nalex09/nalex09/hardware/docs/parts-list.pdf

Part | Link | Price per Package (12.07.23) | Package Size | Pieces needed for one assembly | Price for one assembly (12.07.23)
WiFi Kit ESP32 WiFi Wireless mit 0,96 Zoll OLED Display (causion: buy the Wifi version, no the one with LoRa!) | https://www.amazon.de/gp/product/B078MCR8FY/ref=ppx_yo_dt_b_asin_title_o04_s01?ie=UTF8&psc=1 | 22,99 € | 1 | 1 | 22,99 €
WayinTop 5 Stück Rotary Encoder Modul KY-040 | https://www.amazon.de/gp/product/B07T3672VK/ref=ppx_yo_dt_b_asin_title_o04_s00?ie=UTF8&psc=1 | 10,99 € | 5 | 1 | 2,20 €
Miuzei 270° Digital RC Servo Motor 20KG | https://www.amazon.de/gp/product/B07Q65JY1K/ref=ppx_yo_dt_b_asin_title_o04_s00?ie=UTF8&psc=1 | 15,89 € | 1 | 1 | 15,89 €
diymore Metall Servoarm 25T Disc | https://www.amazon.de/diymore-Metall-Servoarm-MG996R-Roboter/dp/B07G5BTMJB/ref=psdc_12950661_t1_B07F71J1Q2 | 6,99 € | 6 | 1 | 1,17 €
Load Cell 1kg with HX711 | https://www.amazon.de/gp/product/B073GXMDNY/ref=ppx_yo_dt_b_asin_title_o05_s00?ie=UTF8&psc=1 | 9,99 € | 1 | 1 | 9,99 €
RUNCCI-YUN 10pcs 12mm Pushbutton Waterproof | https://www.amazon.de/gp/product/B0B3QYVMVF/ref=ppx_yo_dt_b_asin_title_o05_s01?ie=UTF8&psc=1 | 9,98 € | 10 | 2 | 2,00 €
6 Pieces Rocker switch | https://www.amazon.de/gp/product/B087M7XVHR/ref=ppx_yo_dt_b_asin_title_o05_s01?ie=UTF8&psc=1 | 7,99 € | 6 | 1 | 1,33 €
Hollow plug round plug for power supply 5,5 x2,1 | https://www.ebay.de/itm/165688559733?var=465201624528https://www.ebay.de/itm/162724900298 | 1,86 € | 10 | 1 | 0,19 €
Power supply: 5V / 3000mA (5,5*2,5mm / 2,1mm) | https://www.ebay.de/itm/124101179051?var=425713465497 | 9,19 € | 1 | 1 | 9,19 €
Screw M6 x 50mm | https://www.ebay.de/itm/115139841197?var=415207287757 | 4,45 € | 10 | 1 | 0,45 €
Screw M5 x 20mm Countersunk head | https://www.ebay.de/itm/113997747668?var=414281832157 | 3,92 € | 10 | 2 | 0,78 €
Screw M4 x 20mm Countersunk head | https://www.ebay.de/itm/113997747668?var=414281832072 | 3,67 € | 10 | 2 | 0,73 €
Foliv 570 PCS Edelstahl M3 Screws and nuts assortment 1x M3x30 + Nut + Washers (for the Servo Arm) 2x M3x20 + Nut + Washers (for the Servo Mount) 5x M3x15 + Washers (for mounting Gear to Servo) | https://www.amazon.de/gp/product/B0939L6G9W/ref=ppx_yo_dt_b_asin_title_o03_s02?ie=UTF8&psc=1 | 12,74 € | 570 | 20 | 0,45 €
Imgut® Plastik-Quetschhahn | https://www.holtermann-shop.de/Honigernte/abfuell-eimer-haehne/Imgut---Plastik-Quetschhahn.htmlhttps://www.holtermann-shop.de/honigernte/honig-abfuellen-1562/abfuell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 | 9,90 € | 1 | 1 | 9,90 €
Parts Price for assembly of one unit | 77,25 €
