nalex09/nalex09/hardware/step/housing-upper-part.step

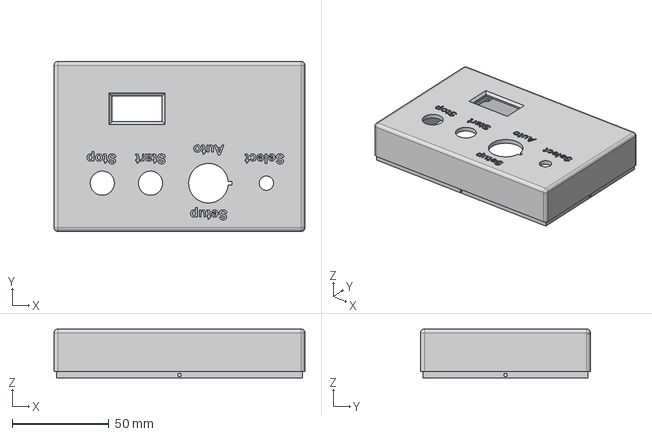
[picture p7: CAD file, 2026-11-11]
hardware/step/housing-upper-part.step
130.0 x 88.0 x 25.4 mm
