nalex09/nalex09/hardware/step/scale-topping-plate.step

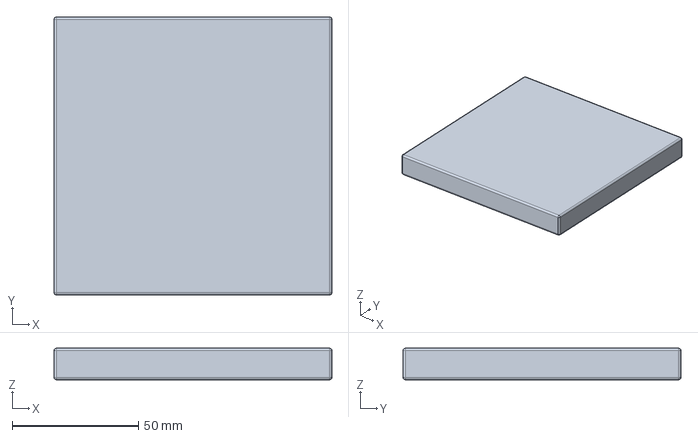
[picture p8: CAD file, 2026-11-11]
hardware/step/scale-topping-plate.step
110.0 x 110.0 x 12.5 mm
