nalex09/nalex09/hardware/step/housing-ground-part.step

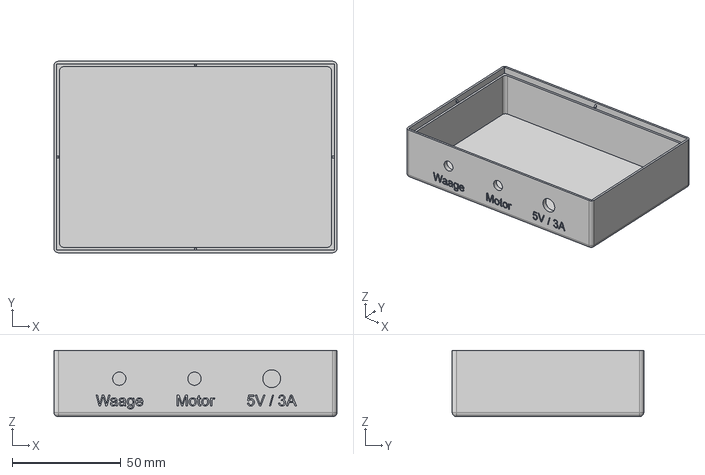
[picture p9: CAD file, 2026-11-11]
hardware/step/housing-ground-part.step
130.0 x 88.0 x 30.5 mm
