nalex09/nalex09/hardware/step/gear-on-servo.step

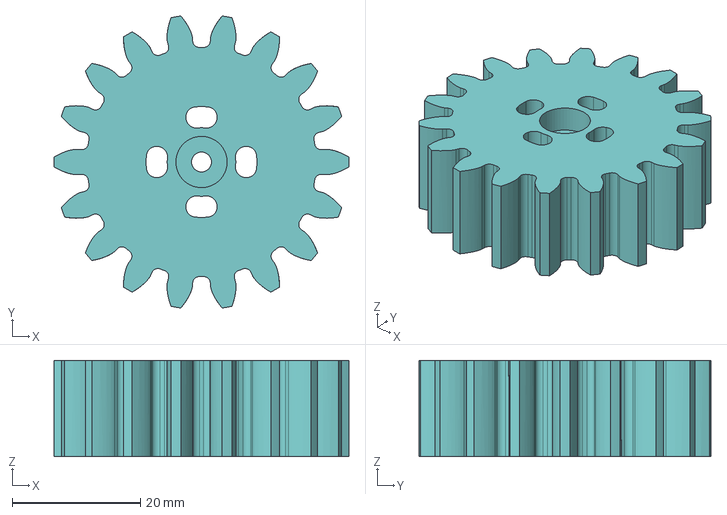
[picture p10: CAD file, 2026-11-11]
hardware/step/gear-on-servo.step
46.0 x 45.5 x 15.0 mm
