nalex09/nalex09/hardware/step/scale-ground-plate.step

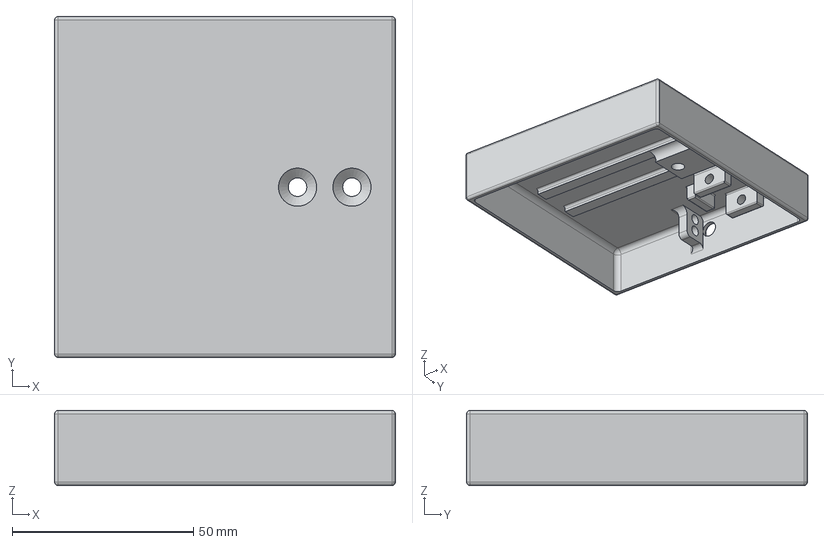
[picture p11: CAD file, 2026-11-11]
hardware/step/scale-ground-plate.step
94.0 x 94.0 x 20.7 mm
