nalex09/nalex09/hardware/step/scale-top-plate.step

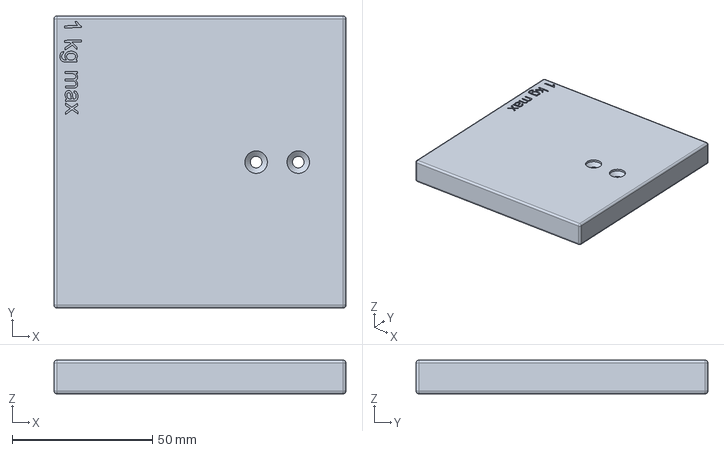
[picture p12: CAD file, 2026-11-11]
hardware/step/scale-top-plate.step
104.0 x 104.0 x 12.0 mm
