nalex09/nalex09/hardware/step/servo-mounting-plate.step

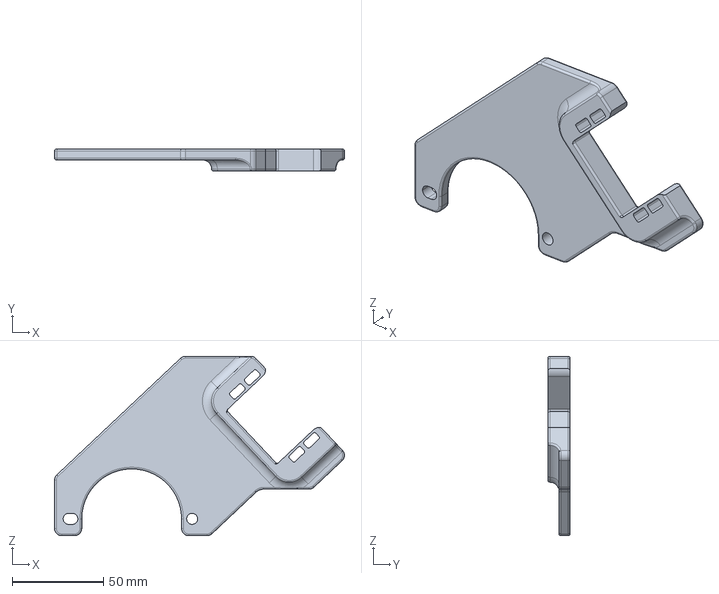
[picture p13: CAD file, 2026-11-11]
hardware/step/servo-mounting-plate.step
158.5 x 12.0 x 98.1 mm
