nalex09/nalex09/hardware/step/gear-arm.step

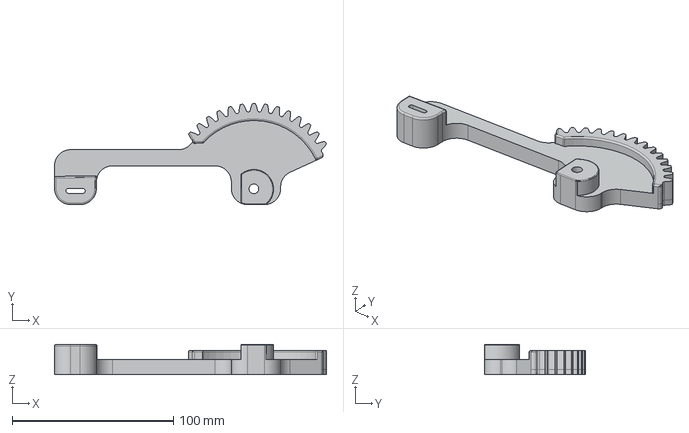
[picture p14: CAD file, 2026-11-11]
hardware/step/gear-arm.step
168.4 x 62.7 x 18.8 mm
