nalex09/nalex09/(list of files, cad)

Other CAD files:
hardware/hanimandl-rallef80.f3d
hardware/stl/gear-arm.stl
hardware/stl/gear-on-servo.stl
hardware/stl/housing-ground-part.stl
hardware/stl/housing-upper-part.stl
hardware/stl/scale-ground-plate.stl
hardware/stl/scale-top-plate.stl
hardware/stl/scale-topping-plate.stl
hardware/stl/servo-mounting-plate.stl
