nalex09/nalex09/hardware/docs/printables-524971-descriere.pdf

## Filling machine "Hanimandl"

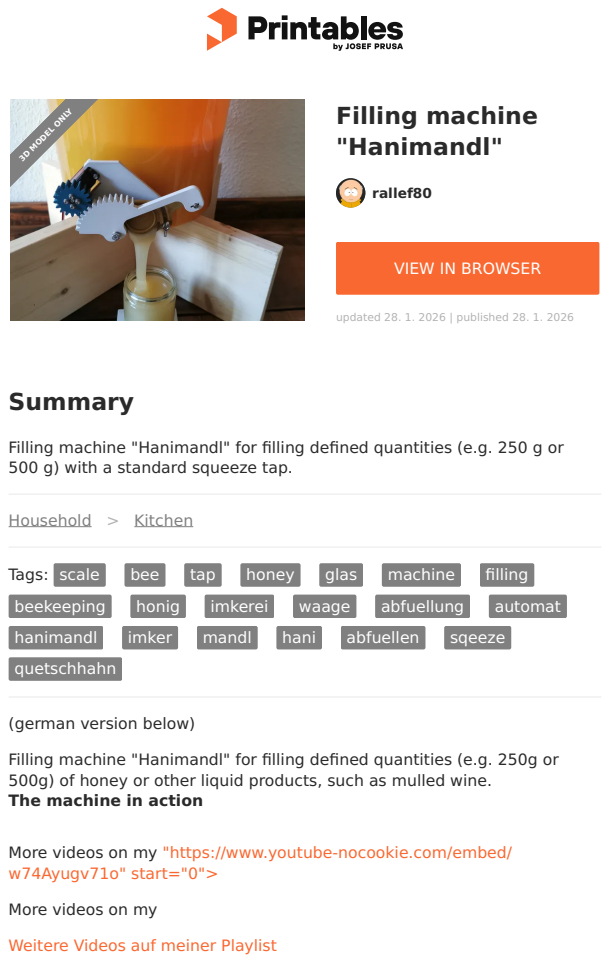
[picture p15: page 1]
Summary; Household > Kitchen; Tags:; scale; bee; tap; honey; glas; machine; filling; beekeeping; honig; imkerei; waage; abfuellung; automat; hanimandl; imker; mandl; hani; abfuellen; sqeeze; quetschhahn; rallef80; updated 28. 1. 2026 | published 28. 1. 2026; 3D MODEL ONLY

VIEW IN BROWSER (https://printables.com/model/524971-filling-machine-hanimandl)

Filling machine "Hanimandl" for filling defined quantities (e.g. 250 g or
500 g) with a standard squeeze tap.

(german version below)

Filling machine "Hanimandl" for filling defined quantities (e.g. 250g or
500g) of honey or other liquid products, such as mulled wine.
The machine in action

More videos on my "https://www.youtube-nocookie.com/embed/
w74Ayugv71o" start="0"> (https://www.youtube.com/playlist?list=PLBxxNxYgCrRPP5T8Fc4HkIMN0lKi9nC2f)

More videos on my

Weitere Videos auf meiner (https://www.youtube.com/playlist?list=PLBxxNxYgCrRPP5T8Fc4HkIMN0lKi9nC2f) Playlist (https://www.youtube.com/playlist?list=PLBxxNxYgCrRPP5T8Fc4HkIMN0lKi9nC2f)

Aufbauanleitung
Eine Bauanleitung für die elektrischen Komponenten und die benötigte Software für den Mikrocontroller sind auf Github zu finden unter: https://github.com/hiveeyes/hanimandl

An dieser Stelle einen herzlichen Dank an das Team von Hanimandl!

Mechanik am Quetschhahn
Abweichend von einigen bereits vorhandenen Konstruktionsvorschlägen arbeitet diese Version hier mit einer Bewegung des Quetschhahns über einen Zahnradantrieb. Dies bietet den Vorteil, dass in jeder Stellung des Hahnes das volle Drehmoment auf den Hahn übertragen werden kann. Der Hahn kann dadurch recht fest verschraubt sein und gut abdichten. Außerdem ist es über diese Konstruktion möglich, den Hahn auch vollständig zu öffnen, was vor allem bei besonders zähen Honigen Vorteile bietet. Die Halterung für den Servomotor ist fest mit dem Quetschhahn verbunden.

Kontrolleinheit
In der Kontrolleinheit sind alle Bedienelemente und der zugehörige Mikrocontroller mit Display eingebracht. Das Gehäuse besteht aus einem Oberteil und einem Unterteil, welche in einander gesteckt werden. Eine Schraubverbindung ist nicht nötig.
Update 11/2023: Das Oberteil des Gehäuses wurde vereinfacht. Der Controller wird jetzt nur eingelegt und mit Sekundenkleber befestigt.

Waage
Die Waage besteht aus drei Einzelteilen. In das Unterteil wird die Wägezelle und die zugehörige Elektronik (HX711) eingesetzt. Anschließend wird die Deckplatte mit der Wägezelle verschraubt. Damit kein Honig auf die Schrauben tropfen kann, kann noch eine Abdeckplatte gedruckt werden, die auf das Oberteil aufgesetzt wird.

Elektronik
Für den Aufbau der Elektronik finden sich Hinweise unter dem oben angegebenen Github-Link. Speziell für den Einsatz des aktuellen Heltec Wifi V3 Controllers, werden unter folgendem Link noch die Pinbelegungen erklärt:
https://community.hiveeyes.org/t/kann-ich-auch-das-heltec-wifi-kit-32-in-der-neuen-version-v3-verwenden/4696/24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 (https://community.hiveeyes.org/t/kann-ich-auch-das-heltec-wifi-kit-32-in-der-neuen-version-v3-verwenden/4696/24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)

Anpassungen an der Software
Damit der Mikrocontroller die richtige Drehrichtung für die Zahnradkonstruktion vornimmt, muss folgende Zeile im Quellcode vorhanden sein (in der Datei “hanimandl.ino” in Zeile 117 einfach die Kommentarzeichen “//” entfernen):

## Model files

#define QUETSCHHAHN_LINKS

Bauteilliste und Projektdatei
Im Anhang befindet sich eine Liste mit Vorschlägen für die Bauteile. Weiterhin ist die Projektdatei für Fusion 360 beigefügt, damit auch Änderungen an der Konstruktion vorgenommen werden können, falls bspw. andere Bedienelemente in das Gehäuse eingepasst werden sollen.

Gedruckt wurden alle Teile in PLA.

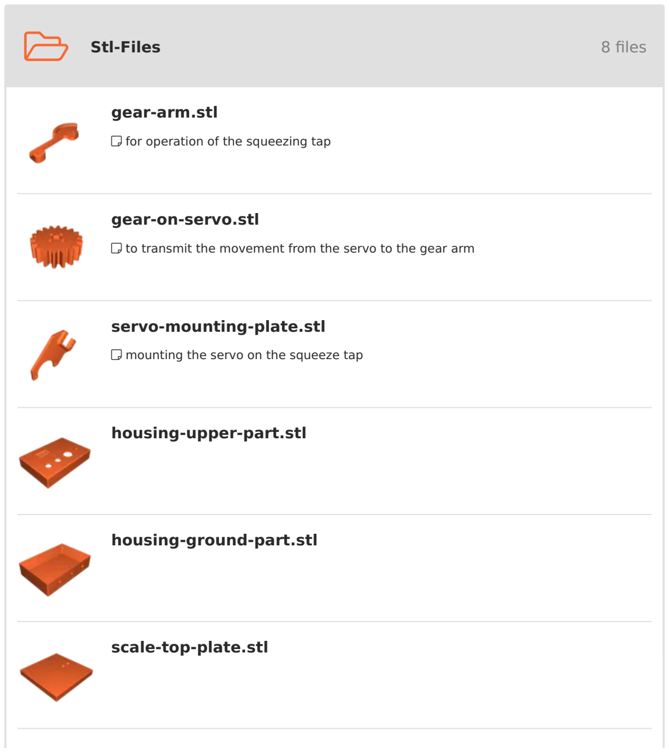
[picture p16: figure]
Stl-Files; 8 files; for operation of the squeezing tap; mounting the servo on the squeeze tap; gear-arm.stl; gear-on-servo.stl; servo-mounting-plate.stl; housing-upper-part.stl; housing-ground-part.stl; scale-top-plate.stl

- to transmit the movement from the servo to the gear arm

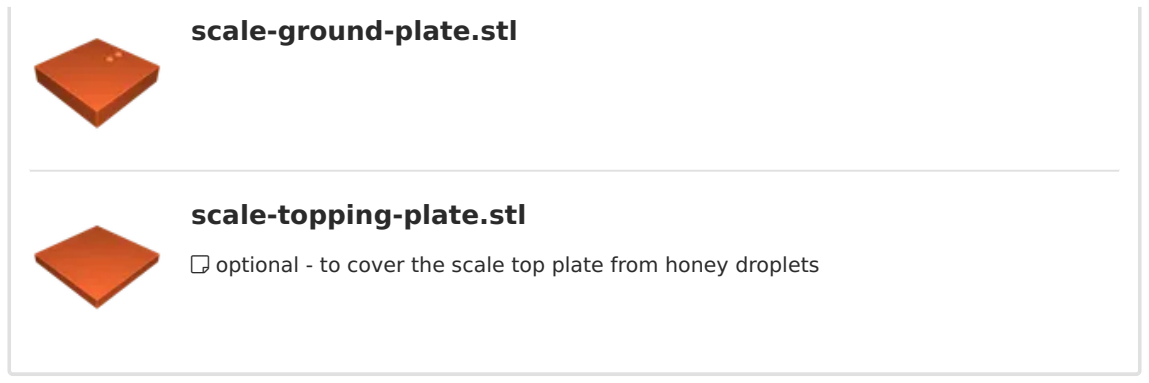
[picture p17: figure]
scale-ground-plate.stl; scale-topping-plate.stl

- optional - to cover the scale top plate from honey droplets
- Step-Files | 8 files
- for operation of the squeezing tap
- to transmit the movement from the servo to the gear arm
- mounting the servo on the squeeze tap
- optional - to cover the scale top plate from honey droplets

gear-arm.step

gear-on-servo.step

servo-mounting-plate.step

housing-upper-part.step

housing-ground-part.step

scale-topping-plate.step

scale-top-plate.step

scale-ground-plate.step

## Other files

## License

This work is licensed under a GNU

General Public License v3.0 (https://www.gnu.org/licenses/gpl-3.0.html)

✖ | Sharing without ATTRIBUTION
✔ | Remix Culture allowed
✔ | Commercial Use
✔ | Meets Open Definition
ℹ | Share under the same license

project.f3d

parts-list.pdf
