nalex09/nalex09/(commit log)

2026-11-11 Add HaniMandl honey filling machine build (Printables #524971)
    Implements the gear-driven "Hanimandl" filling machine by rallef80 on a
    Heltec WiFi Kit 32 V3:
    - firmware/: HaniMandl v0.2.13 from hiveeyes/hanimandl (f425e1e) as a
    PlatformIO project, with QUETSCHHAHN_LINKS enabled as required by the
    gear drive of the Printables model
    - firmware/bin/: prebuilt factory image (flash at 0x0, e.g. esptool-js)
    - docs/: Romanian build guide - parts list, 3D printing, firmware flashing,
    Heltec V3 wiring (table + SVG diagram), assembly, calibration and
    operation with a German->Romanian glossary of the OLED menus,
    troubleshooting
    - CI workflow that builds the firmware and uploads the binaries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
2026-11-11 Add Printables model files and author's parts list
    - hardware/: STL, STEP and Fusion 360 project of Printables #524971
    (rallef80, GPLv3), the author's parts list and description PDFs, plus
    a README mapping each part and screw (hole sizes read from the STEPs)
    - docs: parts list rewritten from the author's BOM (1 kg load cell,
    20 kg 270-degree servo with 25T metal disc, Imgut squeeze tap, 12 mm
    buttons, 20 mm round rocker switch, exact screws); print guide with
    real file names, sizes and bed orientation; assembly steps with the
    exact screws; cable pass-through note
    Claude-Session: https://claude.ai/code/session_01CrnbPa7AhpdW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
    [gear-arm.step, gear-arm.stl, gear-on-servo.step, gear-on-servo.stl, hanimandl-rallef80.f3d, housing-ground-part.step, housing-ground-part.stl, housing-upper-part.step]
2026-11-11 Add step-by-step work plan; switch to 2 kg load cell
    Claude-Session: https://claude.ai/code/session_01CrnbPa7AhpdWUHnkRHAmFt
2026-11-11 Add printable PDF build guide (plan, BOM, parts, wiring, menus)
    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
